jbmister97/projects-hardware/Arduino_Nanite_85/1ec25f11-0269-4718-b098-19f0db2a4db3/Layer_Stack_Manager.png

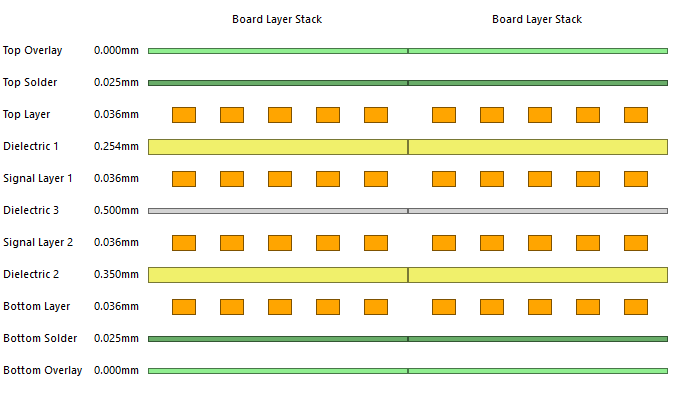
Arduino_Nanite_85/1ec25f11-0269-4718-b098-19f0db2a4db3/Layer_Stack_Manager.png
