jbmister97/projects-hardware/(list of files, drawings)

Other design files:
Arduino_Nanite_85/1ec25f11-0269-4718-b098-19f0db2a4db3/Tiny_Arduino.PrjPcb
Arduino_Nanite_85/1ec25f11-0269-4718-b098-19f0db2a4db3/Tiny_Arduino_Sch.SchDoc
