jbmister97/projects-hardware/Outlet_Relay_V1/Outlet_Relay_V1.kicad_pcb

## KiCad design Outlet_Relay_V1/Outlet_Relay_V1.kicad_pcb (2019-01-05)

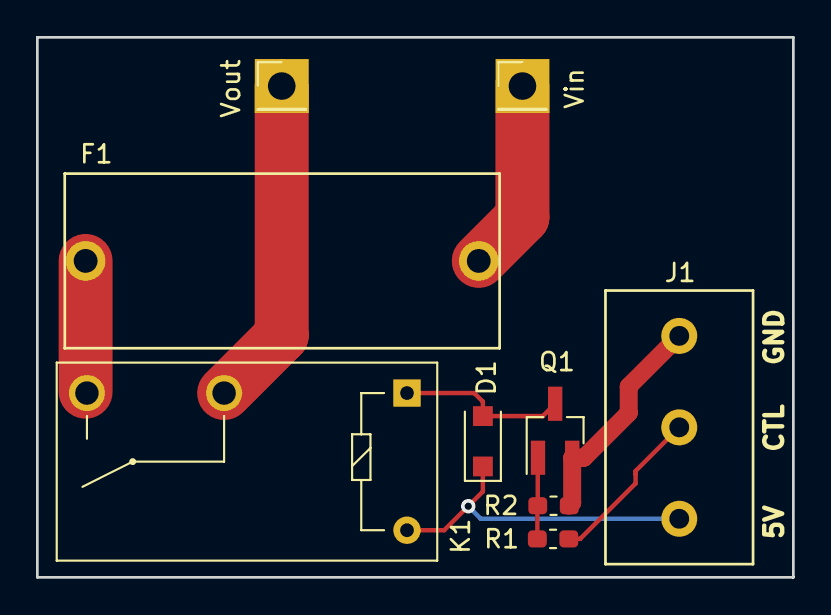
[picture p4: board Outlet_Relay_V1.kicad_pcb from above]

Board: 2 copper layers, 42.0 x 30.0 mm, 9 parts (0 on the bottom side), 8 nets.

Parts:
D1: BAS116H,115; D_SOD-123F
F1: Fuse; Fuse_Holder_Keystone_4527_Cartridge
J1: TerminalBlock_1x3_5.08mmPitch; TerminalBlock_Molex_1x3_5.04mmPitch
K1: G5Q-1A; Relay_SPST_Omron-G5Q-1A
Q1: BSS138K; SOT-23_Handsoldering
R1: 1k; R_0603_1608Metric_Pad1.05x0.95mm_HandSolder
R2: 10k; R_0603_1608Metric_Pad1.05x0.95mm_HandSolder
Vin: PinHeader_1x01_P2.54mm_Vertical
Vout: PinHeader_1x01_P2.54mm_Vertical

Connections:
/5V: D1.1, J1.1, K1.5
/CTL: J1.2, R1.1
GND: J1.3, Q1.2, R2.2
unnamed: D1.2, K1.1, Q1.3
unnamed: F1.1, K1.3
unnamed: Q1.1, R1.2, R2.1
Vin: F1.2, Vin.1
Vout: K1.2, Vout.1
