jbmister97/projects-hardware/Motor_4_Channel_V2/Motor_4_Channel_V2.kicad_pcb

## KiCad design Motor_4_Channel_V2/Motor_4_Channel_V2.kicad_pcb (2019-01-05)

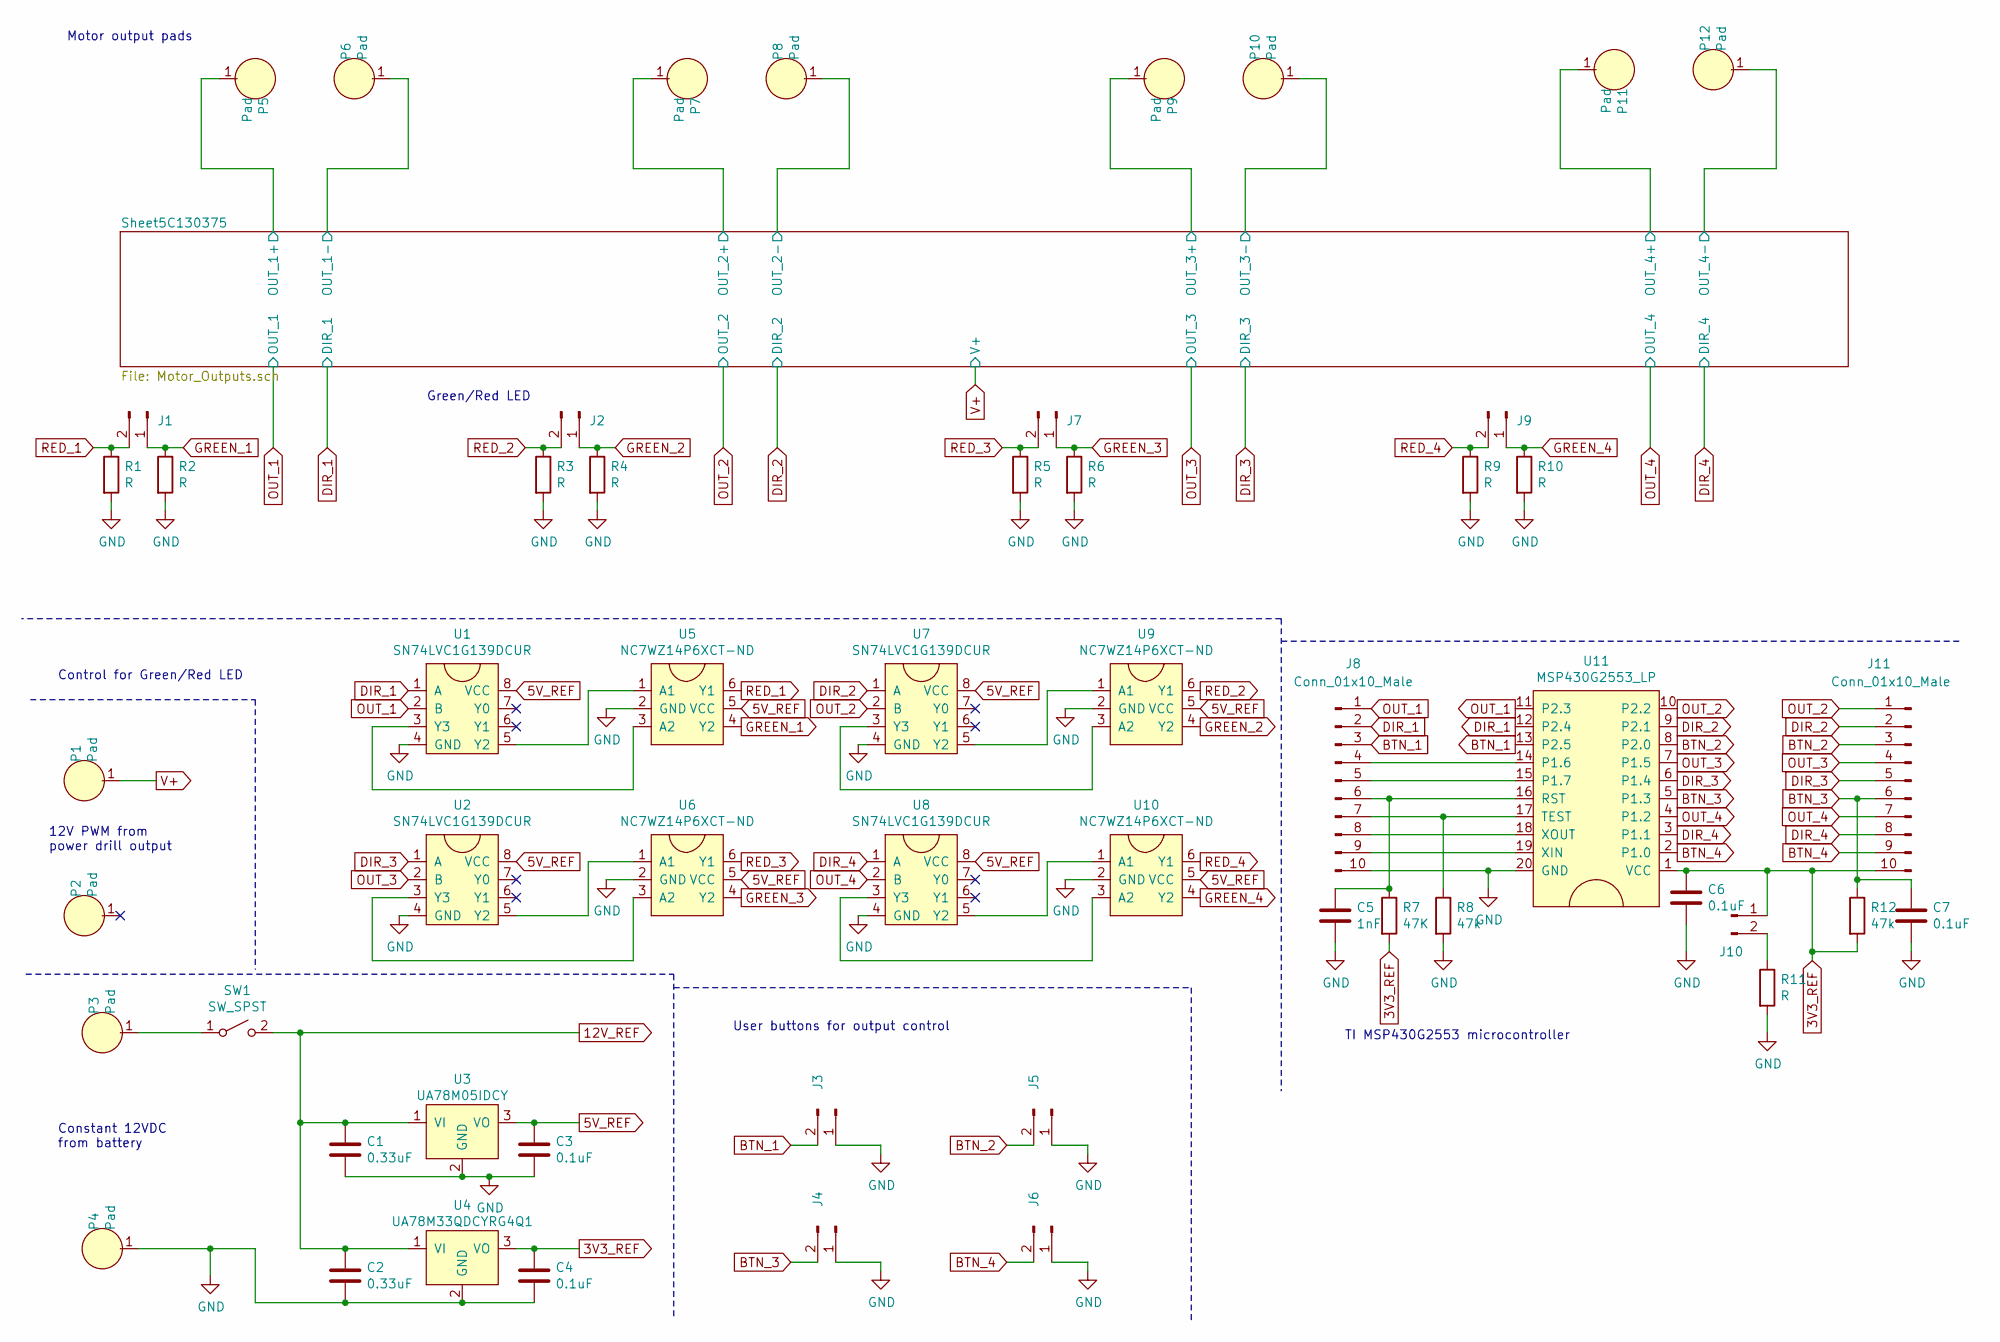
[picture p5: schematic Motor_4_Channel_V2.sch]

Parts:
C1, C2: 0.33uF; C_0603_1608Metric_Pad1.05x0.95mm_HandSolder
C3, C4, C6, C7: 0.1uF; C_0603_1608Metric_Pad1.05x0.95mm_HandSolder
C5: 1nF; C_0603_1608Metric_Pad1.05x0.95mm_HandSolder
J1, J2, J3, J4, J5, J6, J7, J9, J10: Conn_01x02_Male; PinHeader_1x02_P2.54mm_Vertical
J8, J11: Conn_01x10_Male; PinHeader_1x10_P2.54mm_Vertical
P1, P2, P3, P4, P5, P6, P7, P8, P9, P10, P11, P12: Pad
R1, R2, R3, R4, R5, R6, R9, R10, R11: R; R_0603_1608Metric_Pad1.05x0.95mm_HandSolder
R7: 47K; R_0603_1608Metric_Pad1.05x0.95mm_HandSolder
R8, R12: 47k; R_0603_1608Metric_Pad1.05x0.95mm_HandSolder
SW1: SW_SPST; PinHeader_1x02_P2.54mm_Vertical
U1, U2, U7, U8: SN74LVC1G139DCUR; VSSOP-8_2.4x2.1mm_P0.5mm
U3: UA78M05IDCY; SOT-223-3_TabPin2
U4: UA78M33QDCYRG4Q1; SOT-223-3_TabPin2
U5, U6, U9, U10: NC7WZ14P6XCT-ND; SC-70-6
U11: MSP430G2553_LP; DIP-20_W7.62mm_Socket_LongPads

Connections:
3V3_REF: C4.1, C6.1, J10.1, J11.10, R7.2, R12.2, U4.3 (VO), U11.1 (VCC)
5V_REF: C3.1, U1.8 (VCC), U2.8 (VCC), U3.3 (VO), U5.5 (VCC), U6.5 (VCC), U7.8 (VCC), U8.8 (VCC), U9.5 (VCC), U10.5 (VCC)
12V_REF: C1.1, C2.1, SW1.2 (B), U3.1 (VI), U4.1 (VI); also elsewhere on the board
/Sheet5C130375/OUT_1+: P5.1; also elsewhere on the board
/Sheet5C130375/OUT_1-: P6.1; also elsewhere on the board
/Sheet5C130375/OUT_2+: P7.1; also elsewhere on the board
/Sheet5C130375/OUT_2-: P8.1; also elsewhere on the board
/Sheet5C130375/OUT_3+: P9.1; also elsewhere on the board
/Sheet5C130375/OUT_3-: P10.1; also elsewhere on the board
/Sheet5C130375/OUT_4+: P11.1; also elsewhere on the board
/Sheet5C130375/OUT_4-: P12.1; also elsewhere on the board
BTN_1: J3.2, J8.3, U11.13 (P2.5)
BTN_2: J5.2, J11.3, U11.8 (P2.0)
BTN_3: C7.1, J4.2, J11.6, R12.1, U11.5 (P1.3)
BTN_4: J6.2, J11.9, U11.2 (P1.0)
DIR_1: J8.2, U1.1 (A), U11.12 (P2.4); also elsewhere on the board
DIR_2: J11.2, U7.1 (A), U11.9 (P2.1); also elsewhere on the board
DIR_3: J11.5, U2.1 (A), U11.6 (P1.4); also elsewhere on the board
DIR_4: J11.8, U8.1 (A), U11.3 (P1.1); also elsewhere on the board
GND: C1.2, C2.2, C3.2, C4.2, C5.2, C6.2, C7.2, J3.1, J4.1, J5.1, J6.1, J8.10, P4.1, R1.2, R2.2, R3.2, R4.2, R5.2, R6.2, R8.2, R9.2, R10.2, R11.2, U1.4 (GND), U2.4 (GND), U3.2 (GND), U4.2 (GND), U5.2 (GND), U6.2 (GND), U7.4 (GND), U8.4 (GND), U9.2 (GND), U10.2 (GND), U11.20 (GND); also elsewhere on the board
GREEN_1: J1.1, R2.1, U5.4 (Y2)
GREEN_2: J2.1, R4.1, U9.4 (Y2)
GREEN_3: J7.1, R6.1, U6.4 (Y2)
GREEN_4: J9.1, R10.1, U10.4 (Y2)
unnamed: C5.1, J8.6, R7.1, U11.16 (RST)
unnamed: J8.4, U11.14 (P1.6)
unnamed: J8.5, U11.15 (P1.7)
unnamed: J8.7, R8.1, U11.17 (TEST)
unnamed: J8.8, U11.18 (XOUT)
unnamed: J8.9, U11.19 (XIN)
unnamed: J10.2, R11.1
unnamed: P3.1, SW1.1 (A)
unnamed: U1.3 (Y3), U5.3 (A2)
unnamed: U1.5 (Y2), U5.1 (A1)
unnamed: U2.3 (Y3), U6.3 (A2)
unnamed: U2.5 (Y2), U6.1 (A1)
unnamed: U7.3 (Y3), U9.3 (A2)
unnamed: U7.5 (Y2), U9.1 (A1)
unnamed: U8.5 (Y2), U10.1 (A1)
unnamed: U8.3 (Y3), U10.3 (A2)
OUT_1: J8.1, U1.2 (B), U11.11 (P2.3); also elsewhere on the board
OUT_2: J11.1, U7.2 (B), U11.10 (P2.2); also elsewhere on the board
OUT_3: J11.4, U2.2 (B), U11.7 (P1.5); also elsewhere on the board
OUT_4: J11.7, U8.2 (B), U11.4 (P1.2); also elsewhere on the board
RED_1: J1.2, R1.1, U5.6 (Y1)
RED_2: J2.2, R3.1, U9.6 (Y1)
RED_3: J7.2, R5.1, U6.6 (Y1)
RED_4: J9.2, R9.1, U10.6 (Y1)
V+: P1.1; also elsewhere on the board

Notes on the sheet:
Constant 12VDC from battery
12V PWM from power drill output
Control for Green/Red LED
User buttons for output control
TI MSP430G2553 microcontroller
Green/Red LED
Motor output pads

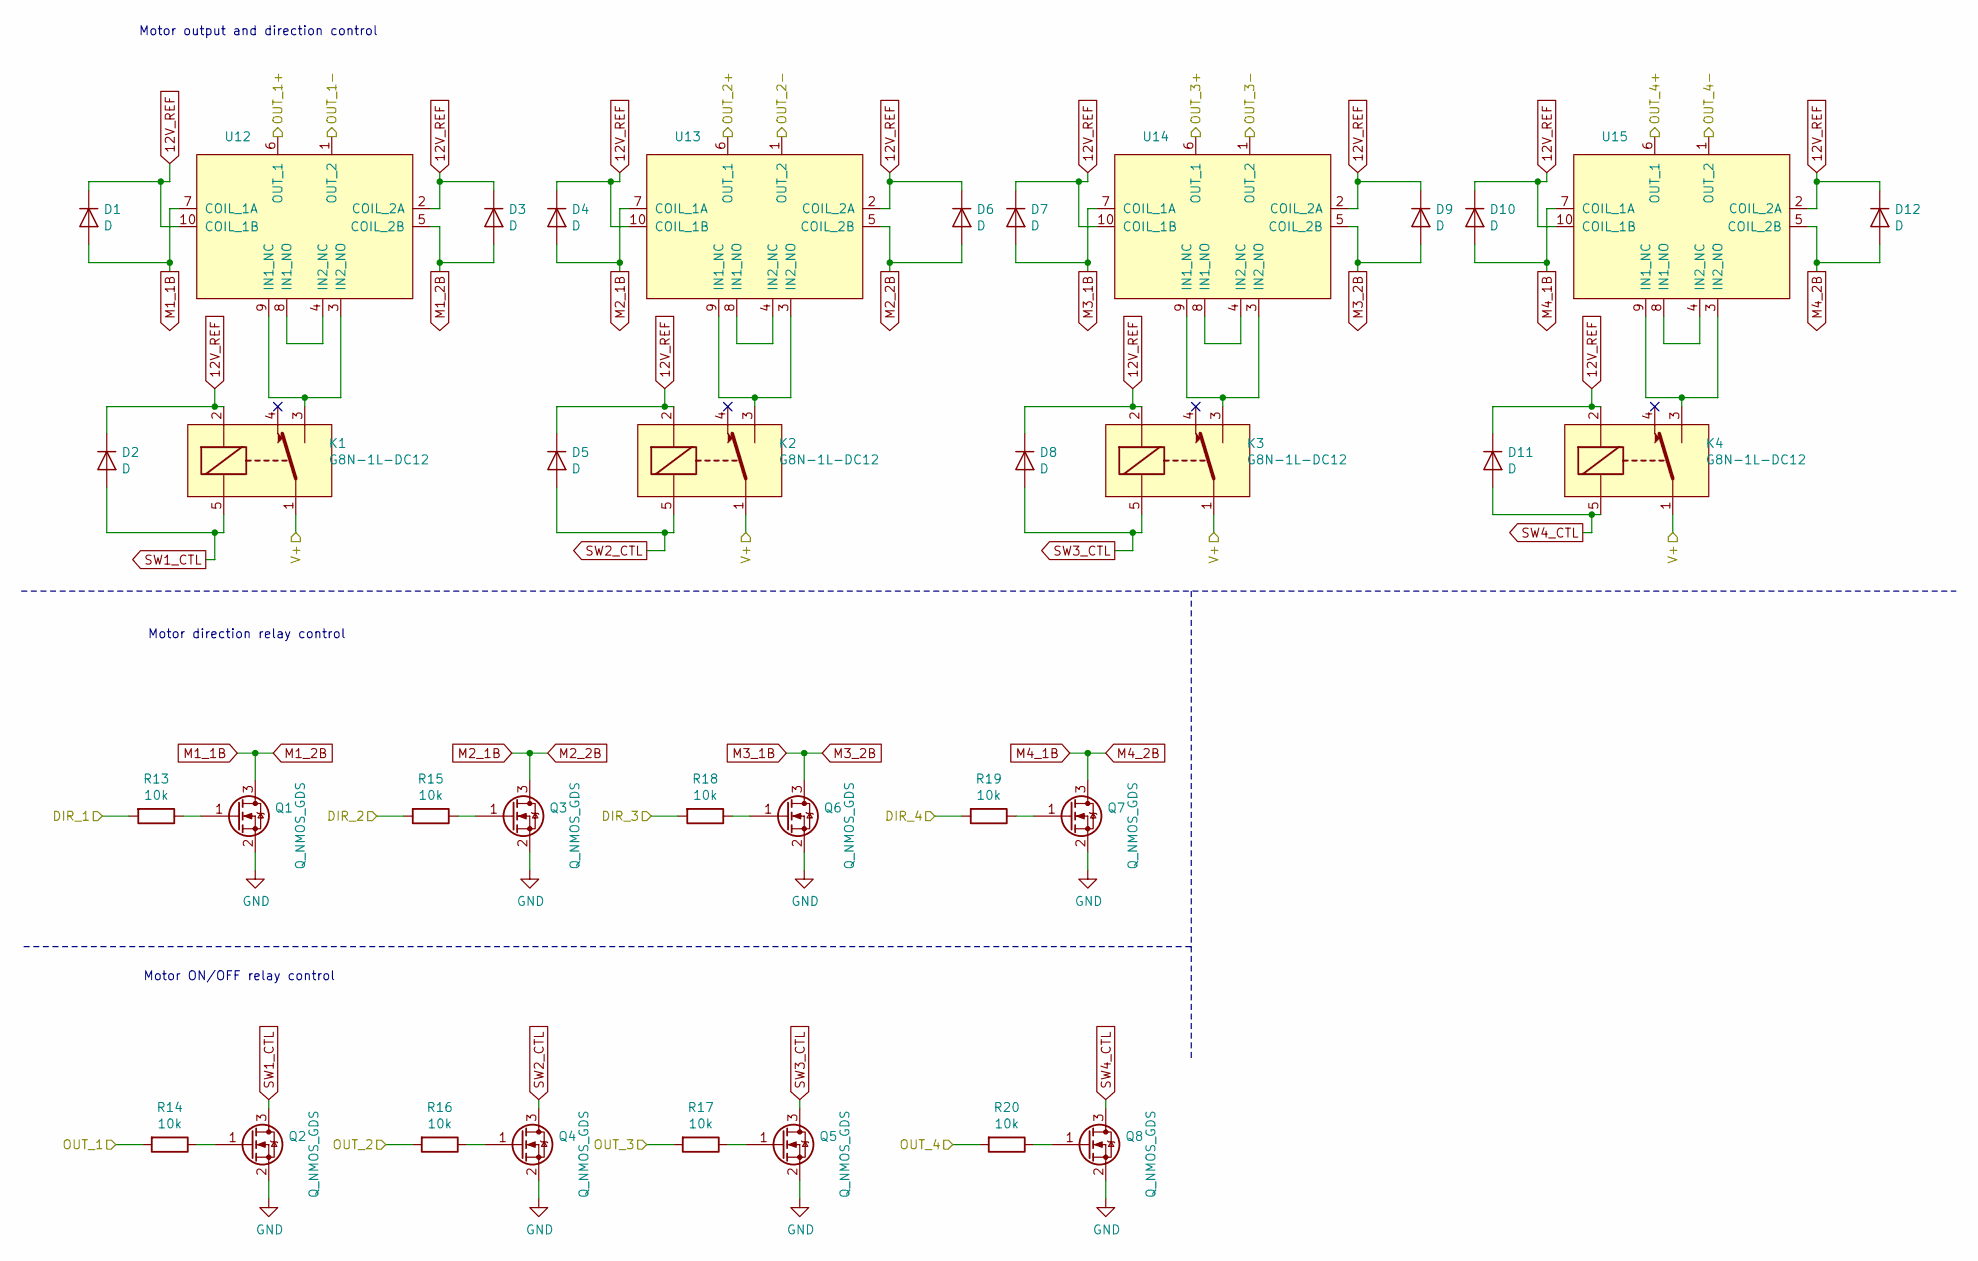
[picture p6: schematic Motor_Outputs.sch]

Parts:
D1, D2, D3, D4, D5, D6, D7, D8, D9, D10, D11, D12: D; DO-214AC
K1, K2, K3, K4: G8N-1L-DC12
Q1, Q2, Q3, Q4, Q5, Q6, Q7, Q8: Q_NMOS_GDS; SOT-23
R13, R14, R15, R16, R17, R18, R19, R20: 10k; R_0603_1608Metric_Pad1.05x0.95mm_HandSolder
U12, U13, U14, U15: G8NW-2H-DC12

Connections:
12V_REF: D1.1 (K), D2.1 (K), D3.1 (K), D4.1 (K), D5.1 (K), D6.1 (K), D7.1 (K), D8.1 (K), D9.1 (K), D10.1 (K), D11.1 (K), D12.1 (K), K1.2, K2.2, K3.2, K4.2, U12.2 (COIL_2A), U12.10 (COIL_1B), U13.2 (COIL_2A), U13.10 (COIL_1B), U14.2 (COIL_2A), U14.10 (COIL_1B), U15.2 (COIL_2A), U15.10 (COIL_1B); also elsewhere on the board
/Sheet5C130375/OUT_1+: U12.6 (OUT_1); also elsewhere on the board
/Sheet5C130375/OUT_1-: U12.1 (OUT_2); also elsewhere on the board
/Sheet5C130375/OUT_2+: U13.6 (OUT_1); also elsewhere on the board
/Sheet5C130375/OUT_2-: U13.1 (OUT_2); also elsewhere on the board
/Sheet5C130375/OUT_3+: U14.6 (OUT_1); also elsewhere on the board
/Sheet5C130375/OUT_3-: U14.1 (OUT_2); also elsewhere on the board
/Sheet5C130375/OUT_4+: U15.6 (OUT_1); also elsewhere on the board
/Sheet5C130375/OUT_4-: U15.1 (OUT_2); also elsewhere on the board
DIR_1: R13.2; also elsewhere on the board
DIR_2: R15.2; also elsewhere on the board
DIR_3: R18.2; also elsewhere on the board
DIR_4: R19.2; also elsewhere on the board
GND: Q1.2 (S), Q2.2 (S), Q3.2 (S), Q4.2 (S), Q5.2 (S), Q6.2 (S), Q7.2 (S), Q8.2 (S); also elsewhere on the board
M1_1B: D1.2 (A), D3.2 (A), Q1.3 (D), U12.5 (COIL_2B), U12.7 (COIL_1A)
M2_1B: D4.2 (A), D6.2 (A), Q3.3 (D), U13.5 (COIL_2B), U13.7 (COIL_1A)
M3_1B: D7.2 (A), D9.2 (A), Q6.3 (D), U14.5 (COIL_2B), U14.7 (COIL_1A)
M4_1B: D10.2 (A), D12.2 (A), Q7.3 (D), U15.5 (COIL_2B), U15.7 (COIL_1A)
unnamed: K1.3, U12.3 (IN2_NO), U12.9 (IN1_NC)
unnamed: K2.3, U13.3 (IN2_NO), U13.9 (IN1_NC)
unnamed: K3.3, U14.3 (IN2_NO), U14.9 (IN1_NC)
unnamed: K4.3, U15.3 (IN2_NO), U15.9 (IN1_NC)
unnamed: Q1.1 (G), R13.1
unnamed: Q2.1 (G), R14.1
unnamed: Q3.1 (G), R15.1
unnamed: Q4.1 (G), R16.1
unnamed: Q5.1 (G), R17.1
unnamed: Q6.1 (G), R18.1
unnamed: Q7.1 (G), R19.1
unnamed: Q8.1 (G), R20.1
unnamed: U12.4 (IN2_NC), U12.8 (IN1_NO)
unnamed: U13.4 (IN2_NC), U13.8 (IN1_NO)
unnamed: U14.4 (IN2_NC), U14.8 (IN1_NO)
unnamed: U15.4 (IN2_NC), U15.8 (IN1_NO)
OUT_1: R14.2; also elsewhere on the board
OUT_2: R16.2; also elsewhere on the board
OUT_3: R17.2; also elsewhere on the board
OUT_4: R20.2; also elsewhere on the board
SW1_CTL: D2.2 (A), K1.5, Q2.3 (D)
SW2_CTL: D5.2 (A), K2.5, Q4.3 (D)
SW3_CTL: D8.2 (A), K3.5, Q5.3 (D)
SW4_CTL: D11.2 (A), K4.5, Q8.3 (D)
V+: K1.1, K2.1, K3.1, K4.1; also elsewhere on the board

Notes on the sheet:
Motor output and direction control
Motor direction relay control
Motor ON/OFF relay control

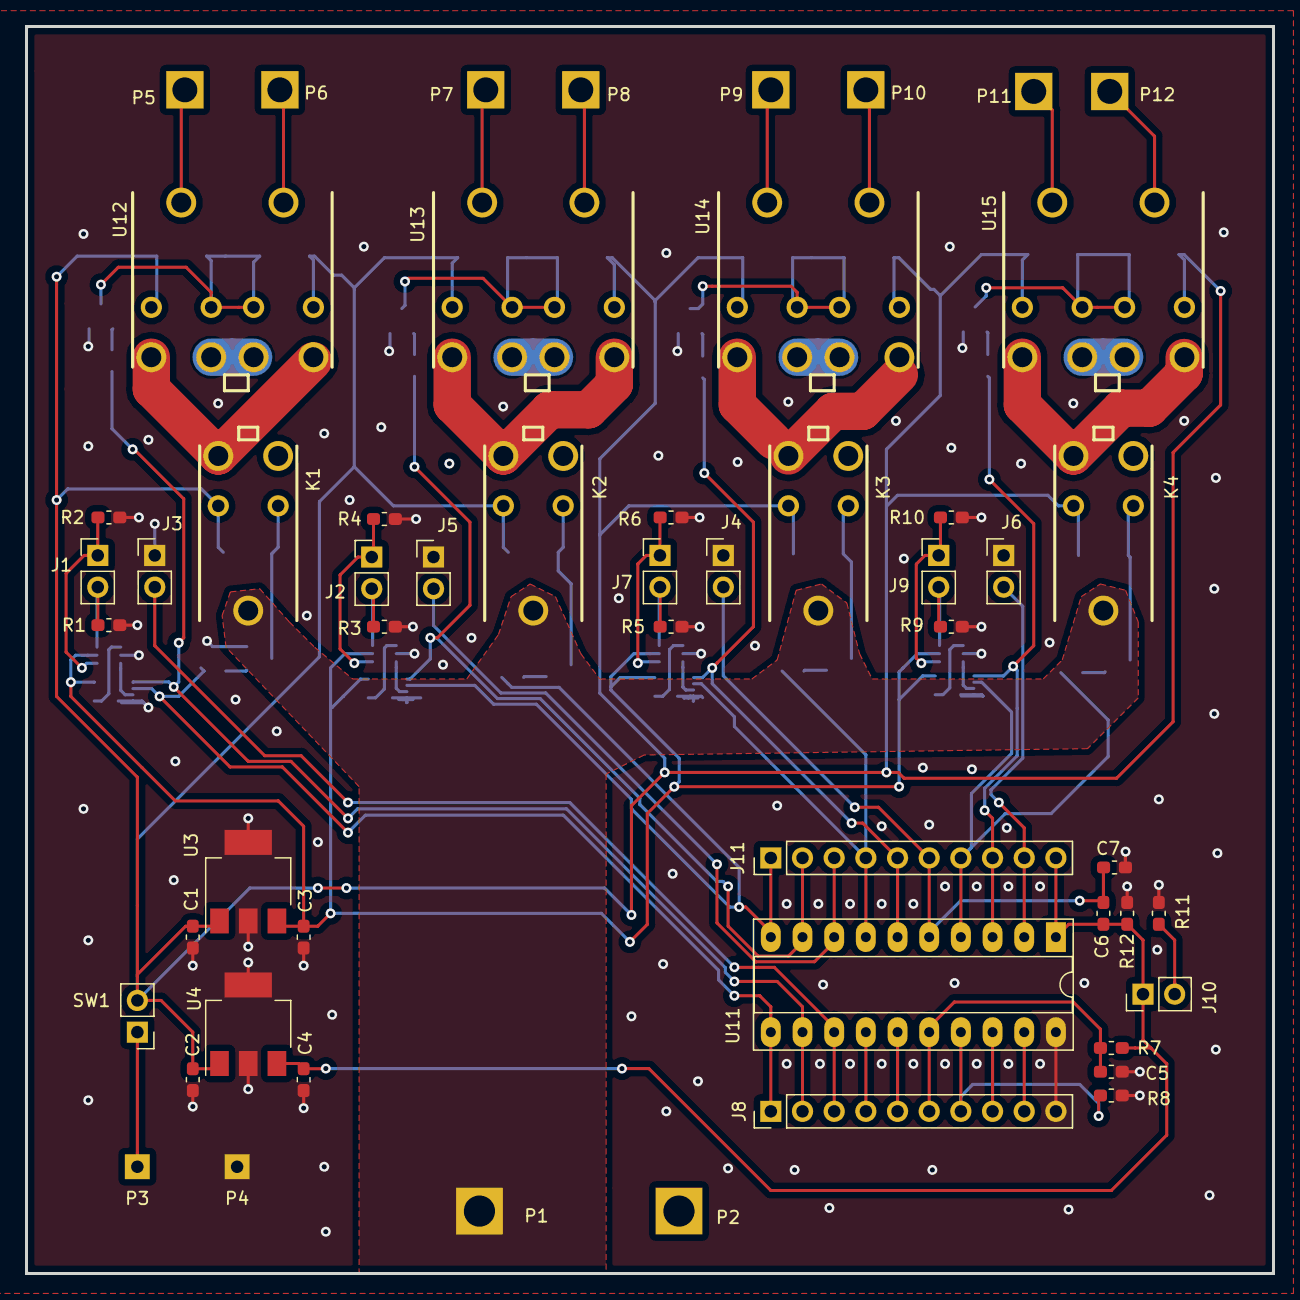
[picture p7: board Motor_4_Channel_V2.kicad_pcb from above]

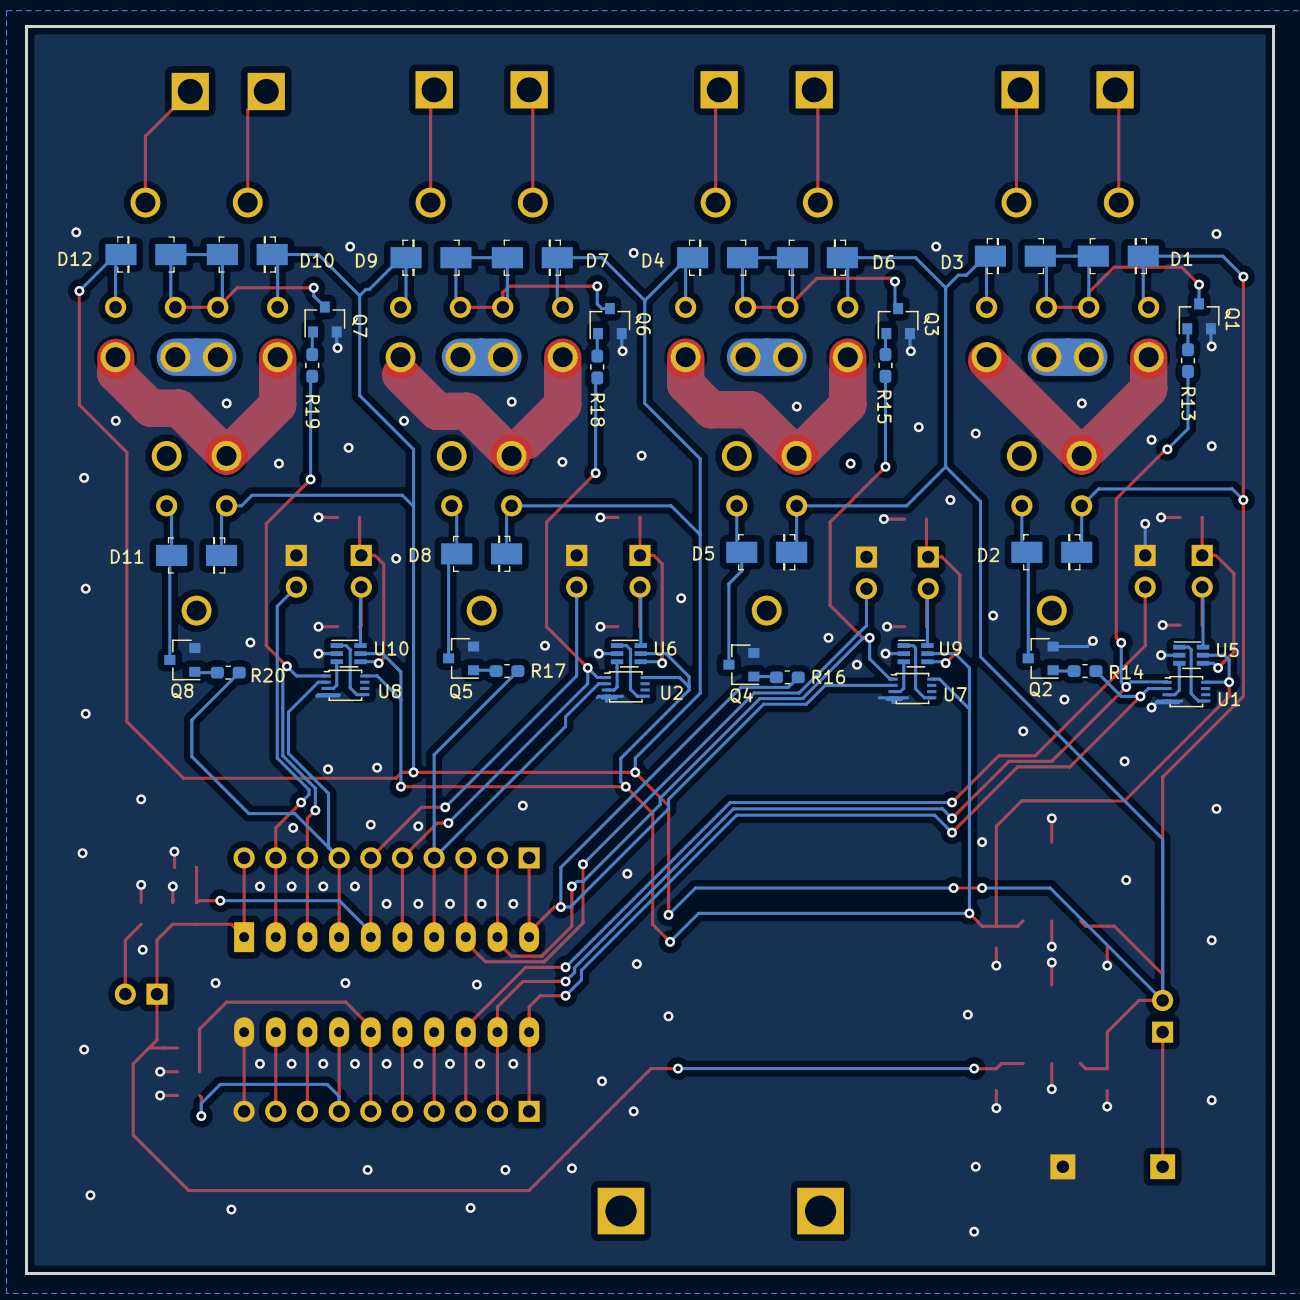
[picture p8: board Motor_4_Channel_V2.kicad_pcb from below]

Board: 2 copper layers, 100.0 x 100.0 mm, 90 parts (36 on the bottom side), 73 nets.
