jbmister97/projects-hardware/Buck_Converter_V1/Buck_Converter_V1.kicad_pcb

## KiCad design Buck_Converter_V1/Buck_Converter_V1.kicad_pcb (2019-01-05)

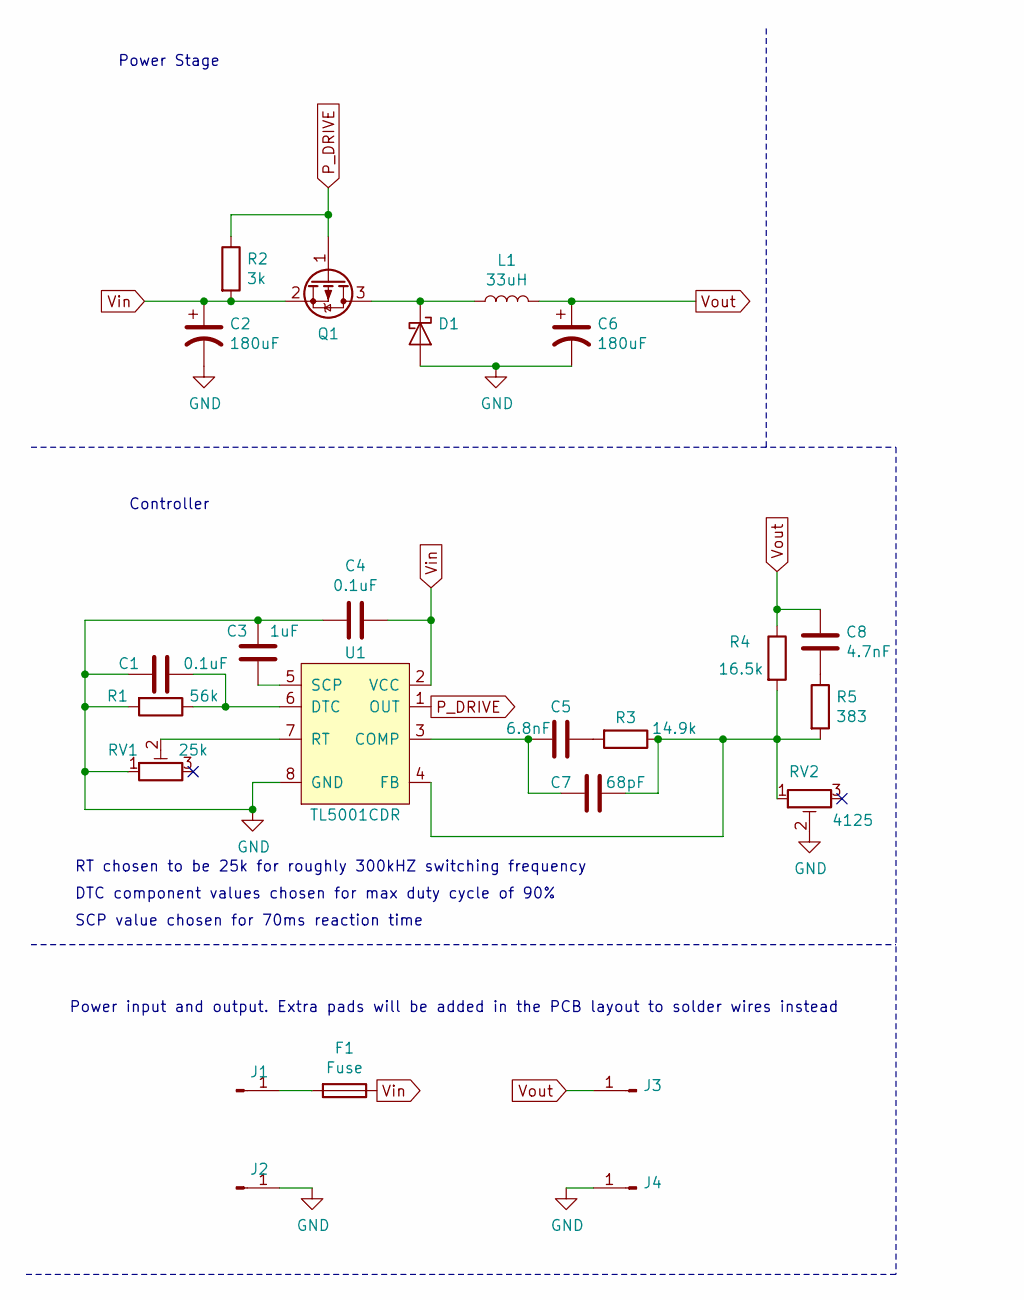
[picture p9: schematic Buck_Converter_V1.sch]

Parts:
C1, C4: 0.1uF; C_0603_1608Metric_Pad1.05x0.95mm_HandSolder
C2, C6: 180uF; C_AlPo_Radial_SMT_8.3mmx8.3mm
C3: 1uF; C_0603_1608Metric_Pad1.05x0.95mm_HandSolder
C5: 6.8nF; C_0603_1608Metric_Pad1.05x0.95mm_HandSolder
C7: 68pF; C_0603_1608Metric_Pad1.05x0.95mm_HandSolder
C8: 4.7nF; C_0603_1608Metric_Pad1.05x0.95mm_HandSolder
D1: NRVTSA4100ET3G; D_SMA_Handsoldering
F1: Fuse; Fuse_0603_1608Metric_Pad1.05x0.95mm_HandSolder
J1, J2, J3, J4: Conn_01x01_Male; PinHeader_1x01_P2.54mm_Vertical
L1: 33uH; L_12x12mm_H8mm
Q1: SI2319CDS-T1-GE3; SOT-23_Handsoldering
R1: 56k; R_0603_1608Metric_Pad1.05x0.95mm_HandSolder
R2: 3k; R_0603_1608Metric_Pad1.05x0.95mm_HandSolder
R3: 14.9k; R_0603_1608Metric_Pad1.05x0.95mm_HandSolder
R4: 16.5k; R_0603_1608Metric_Pad1.05x0.95mm_HandSolder
R5: 383; R_0603_1608Metric_Pad1.05x0.95mm_HandSolder
RV1: 25k; Potentiometer_Bourns_3296W_Vertical
RV2: 4125; Potentiometer_Bourns_3296W_Vertical
U1: TL5001CDR; SOIC-8_3.9x4.9mm_P1.27mm

Connections:
GND: C1.2, C2.2, C3.1, C4.2, C6.2, D1.2 (A), J2.1, J4.1, R1.2, RV1.1, RV2.2, U1.8 (GND); also elsewhere on the board
unnamed: C1.1, R1.1, U1.6 (DTC)
unnamed: C3.2, U1.5 (SCP)
unnamed: C5.1, R3.2
unnamed: C5.2, C7.2, U1.3 (COMP)
unnamed: C7.1, R3.1, R4.2, R5.2, RV2.1, U1.4 (FB)
unnamed: C8.2, R5.1
unnamed: D1.1 (K), L1.1, Q1.3 (D)
unnamed 8: F1.2, J1.1; also elsewhere on the board
unnamed: RV1.2, U1.7 (RT)
P_DRIVE: Q1.1 (G), R2.1, U1.1 (OUT)
Vin: C2.1, C4.1, F1.1, Q1.2 (S), R2.2, U1.2 (VCC)
Vout: C6.1, C8.1, J3.1, L1.2, R4.1; also elsewhere on the board

Notes on the sheet:
Power Stage
Controller
RT chosen to be 25k for roughly 300kHZ switching frequency
DTC component values chosen for max duty cycle of 90%
SCP value chosen for 70ms reaction time
Power input and output. Extra pads will be added in the PCB layout to solder wires instead

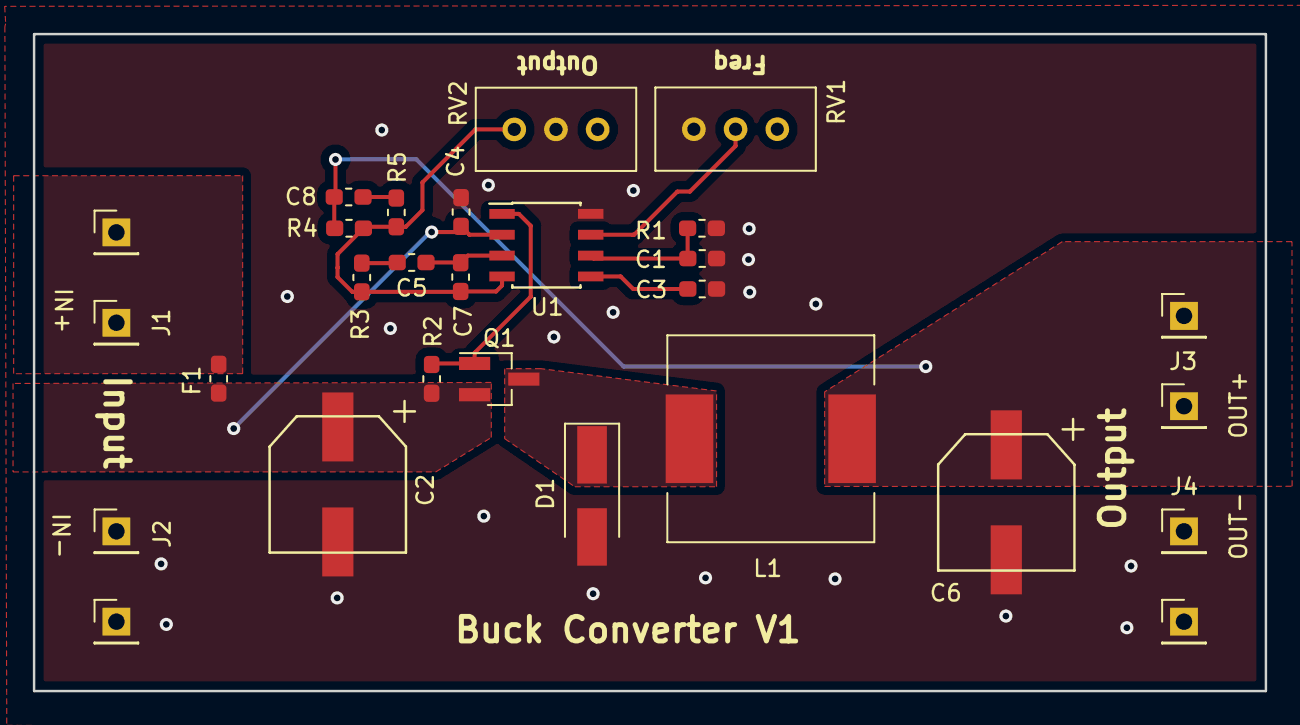
[picture p10: board Buck_Converter_V1.kicad_pcb from above]

Board: 2 copper layers, 75.0 x 40.0 mm, 28 parts (0 on the bottom side), 13 nets.

Other parts of the board:
IN+: PinHeader_1x01_P2.54mm_Vertical
IN-: PinHeader_1x01_P2.54mm_Vertical
OUT+: PinHeader_1x01_P2.54mm_Vertical
OUT-: PinHeader_1x01_P2.54mm_Vertical

Their connections:
GND: IN-.1, OUT-.1; also elsewhere on the board
unnamed 8: IN+.1; also elsewhere on the board
Vout: OUT+.1; also elsewhere on the board
