jbmister97/projects-hardware/NRF52832_Reference/NRF52832_Reference.kicad_pcb

## KiCad design NRF52832_Reference/NRF52832_Reference.kicad_pcb (2018-12-15)

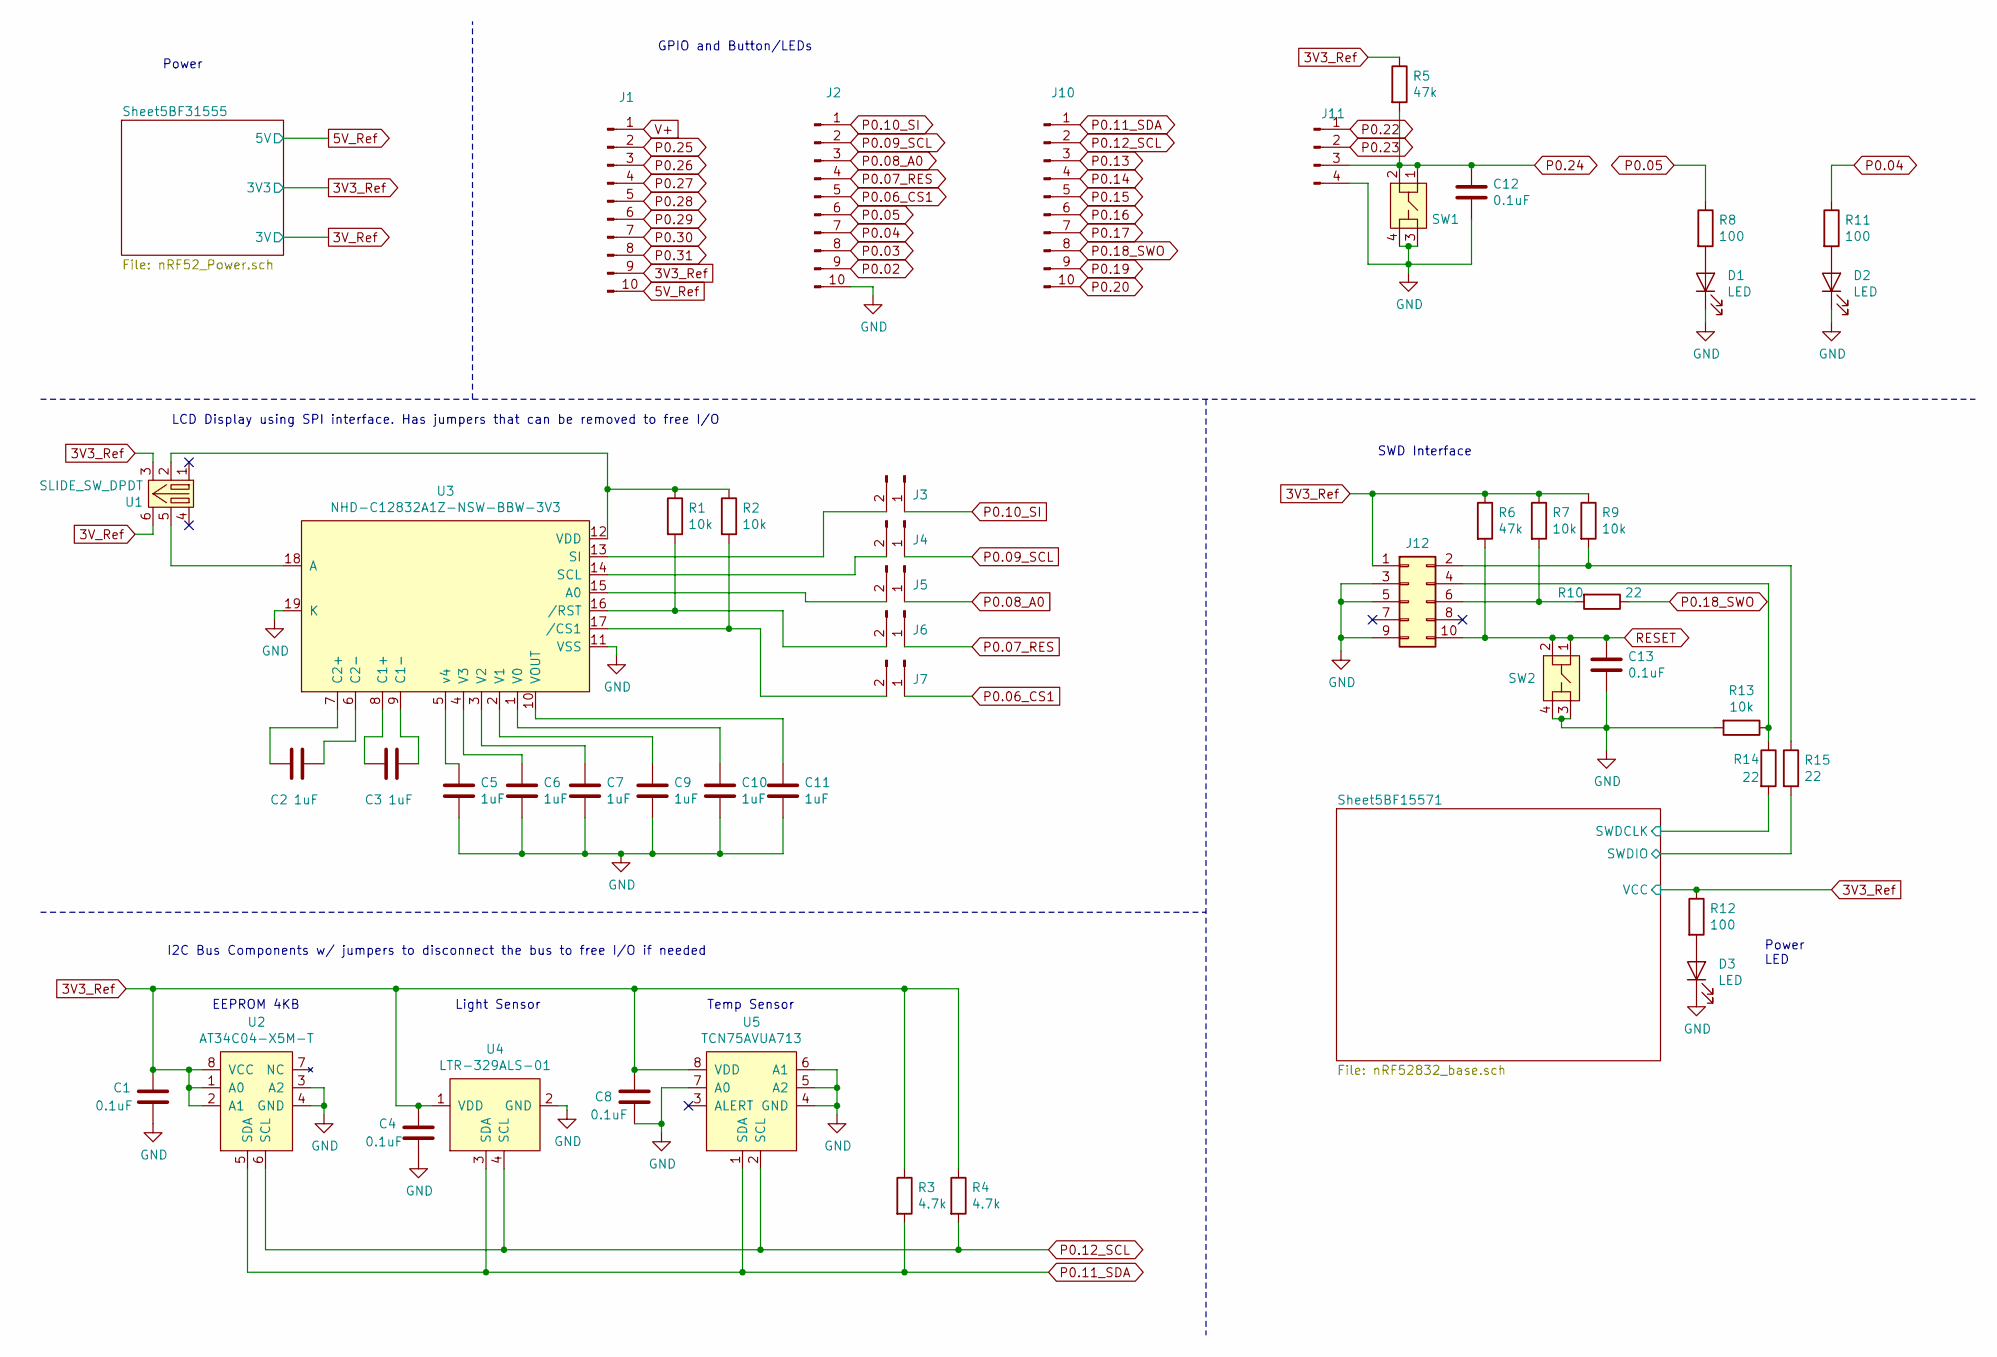
[picture p11: schematic NRF52832_Reference.sch]

Parts:
C1, C4, C8, C12, C13: 0.1uF; C_0603_1608Metric_Pad1.05x0.95mm_HandSolder
C2, C3, C5, C6, C7, C9, C10, C11: 1uF; C_0603_1608Metric_Pad1.05x0.95mm_HandSolder
D1, D2, D3: LED; LED_0603_1608Metric_Pad1.05x0.95mm_HandSolder
J1, J2, J10: Conn_01x10_Male; PinHeader_1x10_P2.54mm_Vertical
J3, J4, J5, J6, J7: Conn_01x02_Male; PinHeader_1x02_P2.54mm_Vertical
J11: Conn_01x04_Male; PinHeader_1x04_P2.54mm_Vertical
J12: SWD_Header; SWD_Header_CNC_Tech_3220-10-0100-00
R1, R2, R7, R9, R13: 10k; R_0603_1608Metric_Pad1.05x0.95mm_HandSolder
R3, R4: 4.7k; R_0603_1608Metric_Pad1.05x0.95mm_HandSolder
R5, R6: 47k; R_0603_1608Metric_Pad1.05x0.95mm_HandSolder
R8, R11, R12: 100; R_0603_1608Metric_Pad1.05x0.95mm_HandSolder
R10, R14, R15: 22; R_0603_1608Metric_Pad1.05x0.95mm_HandSolder
SW1, SW2: Button; SW_Tactile_TE_1825910-6
U1: SLIDE_SW_DPDT; SW_DPDT_Slide_JS202011CQN
U2: AT34C04-X5M-T; TSSOP-8_4.4x3mm_P0.65mm
U3: NHD-C12832A1Z-NSW-BBW-3V3; LCD_NHD-C12832A1Z-NSW-BBW-3V3
U4: LTR-329ALS-01; Sensor_Photo_LTR-329ALS-01
U5: TCN75AVUA713; MSOP-8_3x3mm_P0.65mm

Connections:
3V3_Ref: C1.1, C4.1, C8.1, J1.9, J12.1, R3.1, R4.1, R5.1, R6.1, R7.1, R9.1, R12.1, U1.3, U2.1 (A0), U2.2 (A1), U2.8 (VCC), U4.1 (VDD), U5.8 (VDD); also elsewhere on the board
3V_Ref: U1.6; also elsewhere on the board
5V_Ref: J1.10; also elsewhere on the board
/Sheet5BF15571/SWDCLK: R14.2; also elsewhere on the board
/Sheet5BF15571/SWDIO: R15.2; also elsewhere on the board
GND: C1.2, C4.2, C5.2, C6.2, C7.2, C8.2, C9.2, C10.2, C11.2, C12.2, C13.2, D1.1 (K), D2.1 (K), D3.1 (K), J2.10, J11.4, J12.3, J12.5, J12.9, R13.2, SW1.3, SW1.4, SW2.3, SW2.4, U2.3 (A2), U2.4 (GND), U3.11 (VSS), U3.19 (K), U4.2 (GND), U5.4 (GND), U5.5 (A2), U5.6 (A1), U5.7 (A0); also elsewhere on the board
unnamed: C2.1, U3.6 (C2-)
unnamed: C2.2, U3.7 (C2+)
unnamed: C3.1, U3.9 (C1-)
unnamed: C3.2, U3.8 (C1+)
unnamed: C5.1, U3.5 (v4)
unnamed: C6.1, U3.4 (V3)
unnamed: C7.1, U3.3 (V2)
unnamed: C9.1, U3.2 (V1)
unnamed: C10.1, U3.1 (V0)
unnamed: C11.1, U3.10 (VOUT)
unnamed: D1.2 (A), R8.2
unnamed: D2.2 (A), R11.2
unnamed: D3.2 (A), R12.2
unnamed: J3.2, U3.13 (SI)
unnamed: J4.2, U3.14 (SCL)
unnamed: J5.2, U3.15 (A0)
unnamed: J6.2, R1.2, U3.16 (/RST)
unnamed: J7.2, R2.2, U3.17 (/CS1)
unnamed: J12.2, R9.2, R15.1
unnamed: J12.4, R13.1, R14.1
unnamed: J12.6, R7.2, R10.2
unnamed: R1.1, R2.1, U1.2, U3.12 (VDD)
unnamed: U1.5, U3.18 (A)
P0.02: J2.9; also elsewhere on the board
P0.03: J2.8; also elsewhere on the board
P0.04: J2.7, R11.1; also elsewhere on the board
P0.05: J2.6, R8.1; also elsewhere on the board
P0.06_CS1: J2.5, J7.1; also elsewhere on the board
P0.07_RES: J2.4, J6.1; also elsewhere on the board
P0.08_A0: J2.3, J5.1; also elsewhere on the board
P0.09_SCL: J2.2, J4.1; also elsewhere on the board
P0.10_SI: J2.1, J3.1; also elsewhere on the board
P0.11_SDA: J10.1, R3.2, U2.5 (SDA), U4.3 (SDA), U5.1 (SDA); also elsewhere on the board
P0.12_SCL: J10.2, R4.2, U2.6 (SCL), U4.4 (SCL), U5.2 (SCL); also elsewhere on the board
P0.13: J10.3; also elsewhere on the board
P0.14: J10.4; also elsewhere on the board
P0.15: J10.5; also elsewhere on the board
P0.16: J10.6; also elsewhere on the board
P0.17: J10.7; also elsewhere on the board
P0.18_SWO: J10.8, R10.1; also elsewhere on the board
P0.19: J10.9; also elsewhere on the board
P0.20: J10.10; also elsewhere on the board
P0.22: J11.1; also elsewhere on the board
P0.23: J11.2; also elsewhere on the board
P0.24: C12.1, J11.3, R5.2, SW1.1, SW1.2; also elsewhere on the board
P0.25: J1.2; also elsewhere on the board
P0.26: J1.3; also elsewhere on the board
P0.27: J1.4; also elsewhere on the board
P0.28: J1.5; also elsewhere on the board
P0.29: J1.6; also elsewhere on the board
P0.30: J1.7; also elsewhere on the board
P0.31: J1.8; also elsewhere on the board
RESET: C13.1, J12.10, R6.2, SW2.1, SW2.2; also elsewhere on the board
V+: J1.1; also elsewhere on the board

Notes on the sheet:
SWD Interface
Power
Power LED
I2C Bus Components w/ jumpers to disconnect the bus to free I/O if needed
Light Sensor
Temp Sensor
EEPROM 4KB
LCD Display using SPI interface. Has jumpers that can be removed to free I/O
GPIO and Button/LEDs
