jbmister97/projects-hardware/NRF52832_Reference/NRF52832_Reference.kicad_pcb

## KiCad design NRF52832_Reference/NRF52832_Reference.kicad_pcb (continued)

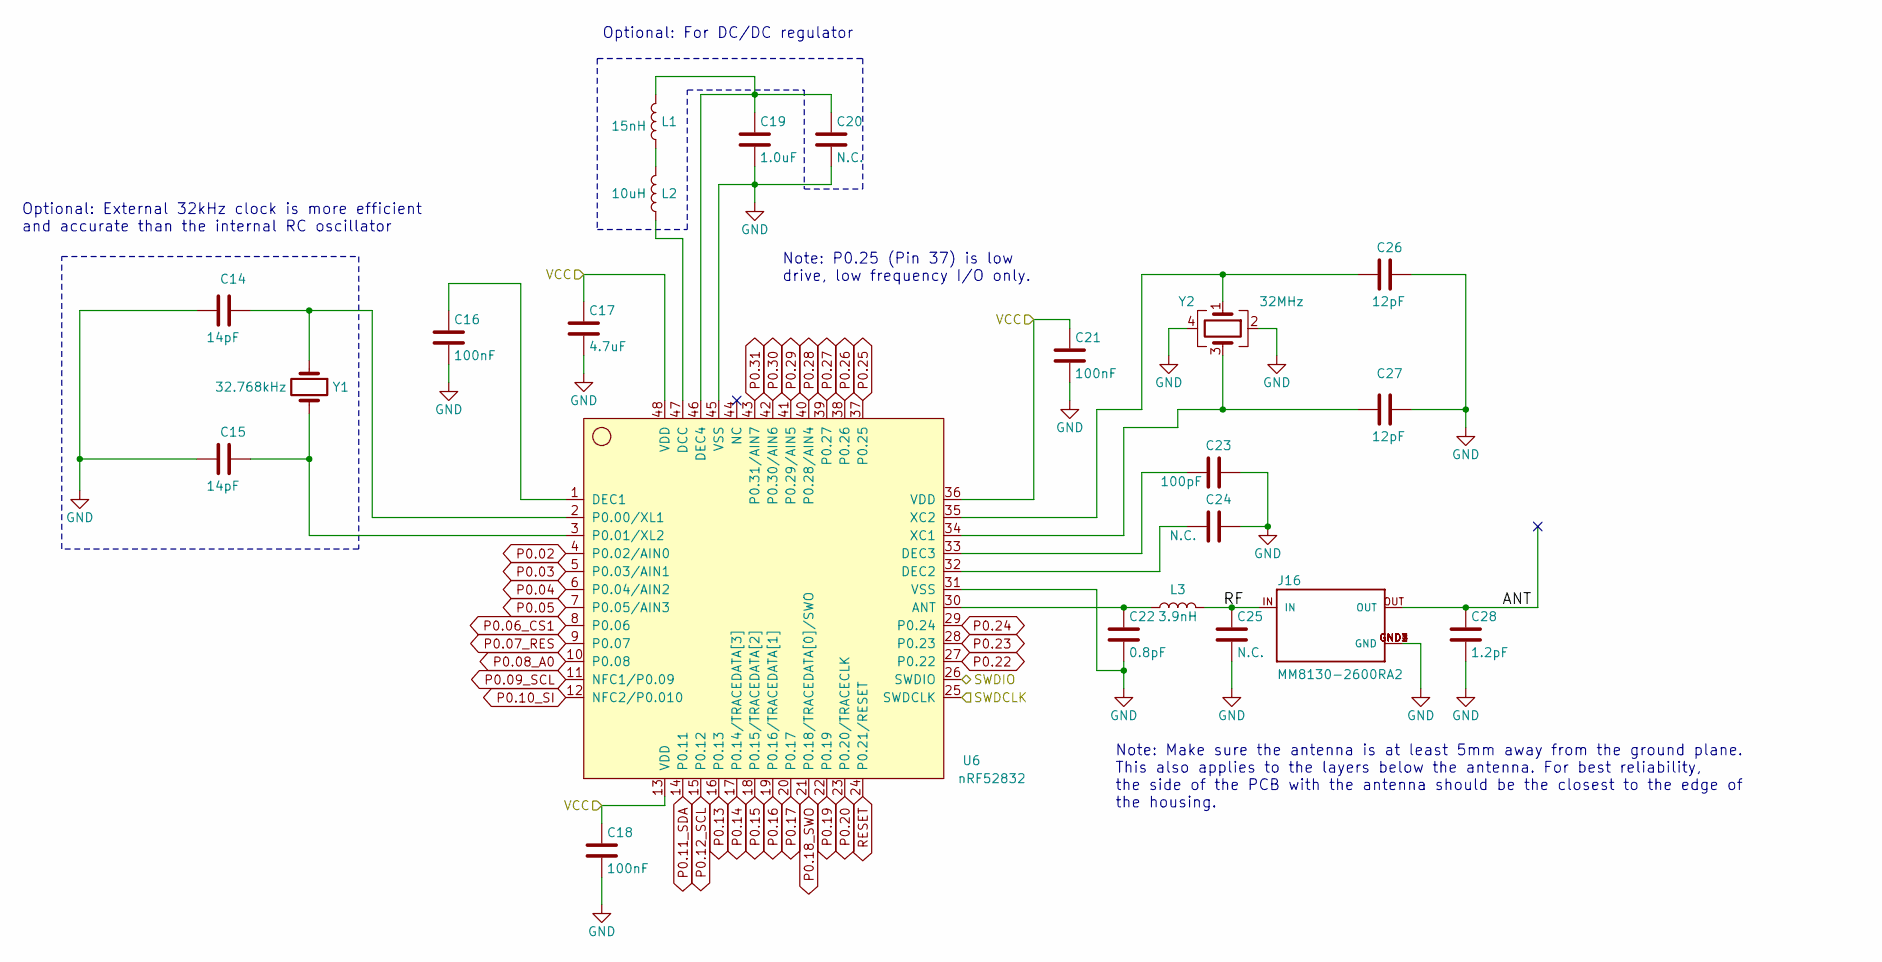
[picture p12: schematic nRF52832_base.sch]

Parts:
C14, C15: 14pF; C_0402_1005Metric
C16, C18, C21: 100nF; C_0402_1005Metric
C17: 4.7uF; C_0603_1608Metric
C19: 1.0uF; C_0603_1608Metric
C20: N.C.; C_0603_1608Metric
C22: 0.8pF; C_0402_1005Metric
C23: 100pF; C_0402_1005Metric
C24, C25: N.C.; C_0402_1005Metric
C26, C27: 12pF; C_0402_1005Metric
C28: 1.2pF; C_0402_1005Metric
J16: MM8130-2600RA2; MURATA_MM8130-2600RA2
L1: 15nH; L_0402_1005Metric
L2: 10uH; L_0603_1608Metric
L3: 3.9nH; L_0402_1005Metric
U6: nRF52832; QFN-48-1EP_6x6mm_P0.4mm_EP4.3x4.3mm_ThermalVias
Y1: 32.768kHz; Crystal_SMD_3215-2Pin_3.2x1.5mm
Y2: 32MHz; Crystal_32MHz_Kyocera_CX3225SB32000D0FFFCC

Connections:
3V3_Ref: C17.1, C18.1, C21.1, U6.13 (VDD), U6.36 (VDD), U6.48 (VDD); also elsewhere on the board
/Sheet5BF15571/ANT: C28.1, J16.OUT
/Sheet5BF15571/RF: C25.1, J16.IN, L3.2
/Sheet5BF15571/SWDCLK: U6.25 (SWDCLK); also elsewhere on the board
/Sheet5BF15571/SWDIO: U6.26 (SWDIO); also elsewhere on the board
GND: C14.2, C15.2, C16.2, C17.2, C18.2, C19.2, C20.2, C21.2, C22.2, C23.1, C24.1, C25.2, C26.1, C27.1, C28.2, J16.GND1 (GND), J16.GND2 (GND), J16.GND3 (GND), J16.GND4 (GND), U6.31 (VSS), U6.45 (VSS), U6.49, Y2.2, Y2.4; also elsewhere on the board
unnamed: C14.1, U6.2 (P0.00/XL1), Y1.1
unnamed: C15.1, U6.3 (P0.01/XL2), Y1.2
unnamed: C16.1, U6.1 (DEC1)
unnamed: C19.1, C20.1, L1.2, U6.46 (DEC4)
unnamed: C22.1, L3.1, U6.30 (ANT)
unnamed: C23.2, U6.33 (DEC3)
unnamed: C24.2, U6.32 (DEC2)
unnamed: C26.2, U6.35 (XC2), Y2.1
unnamed: C27.2, U6.34 (XC1), Y2.3
unnamed: L1.1, L2.2
unnamed: L2.1, U6.47 (DCC)
P0.02: U6.4 (P0.02/AIN0); also elsewhere on the board
P0.03: U6.5 (P0.03/AIN1); also elsewhere on the board
P0.04: U6.6 (P0.04/AIN2); also elsewhere on the board
P0.05: U6.7 (P0.05/AIN3); also elsewhere on the board
P0.06_CS1: U6.8 (P0.06); also elsewhere on the board
P0.07_RES: U6.9 (P0.07); also elsewhere on the board
P0.08_A0: U6.10 (P0.08); also elsewhere on the board
P0.09_SCL: U6.11 (NFC1/P0.09); also elsewhere on the board
P0.10_SI: U6.12 (NFC2/P0.010); also elsewhere on the board
P0.11_SDA: U6.14 (P0.11); also elsewhere on the board
P0.12_SCL: U6.15 (P0.12); also elsewhere on the board
P0.13: U6.16 (P0.13); also elsewhere on the board
P0.14: U6.17 (P0.14/TRACEDATA[3]); also elsewhere on the board
P0.15: U6.18 (P0.15/TRACEDATA[2]); also elsewhere on the board
P0.16: U6.19 (P0.16/TRACEDATA[1]); also elsewhere on the board
P0.17: U6.20 (P0.17); also elsewhere on the board
P0.18_SWO: U6.21 (P0.18/TRACEDATA[0]/SWO); also elsewhere on the board
P0.19: U6.22 (P0.19); also elsewhere on the board
P0.20: U6.23 (P0.20/TRACECLK); also elsewhere on the board
P0.22: U6.27 (P0.22); also elsewhere on the board
P0.23: U6.28 (P0.23); also elsewhere on the board
P0.24: U6.29 (P0.24); also elsewhere on the board
P0.25: U6.37 (P0.25); also elsewhere on the board
P0.26: U6.38 (P0.26); also elsewhere on the board
P0.27: U6.39 (P0.27); also elsewhere on the board
P0.28: U6.40 (P0.28/AIN4); also elsewhere on the board
P0.29: U6.41 (P0.29/AIN5); also elsewhere on the board
P0.30: U6.42 (P0.30/AIN6); also elsewhere on the board
P0.31: U6.43 (P0.31/AIN7); also elsewhere on the board
RESET: U6.24 (P0.21/RESET); also elsewhere on the board

Notes on the sheet:
Note: Make sure the antenna is at least 5mm away from the ground plane. This also applies to the layers below the antenna. For best reliability, the side of the PCB with the antenna should be the closest to the edge of the housing.
Optional: For DC/DC regulator
Optional: External 32kHz clock is more efficient and accurate than the internal RC oscillator
Note: P0.25 (Pin 37) is low drive, low frequency I/O only.

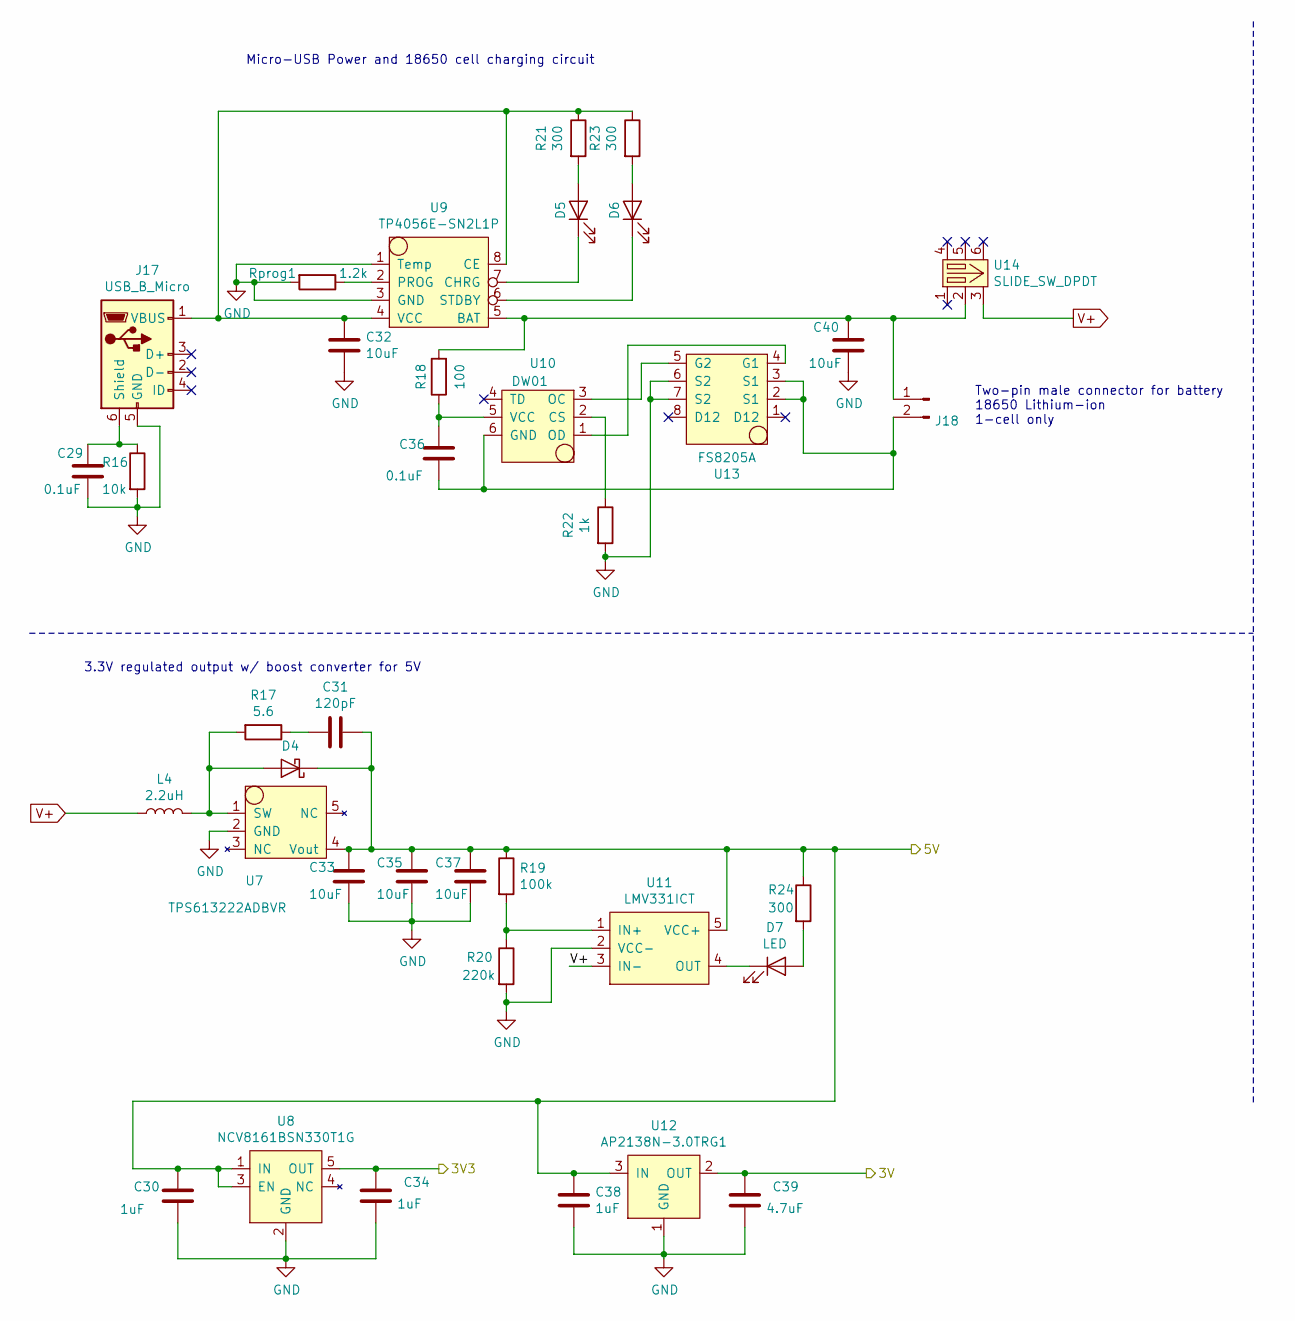
[picture p13: schematic nRF52_Power.sch]

Parts:
C29, C36: 0.1uF; C_0603_1608Metric_Pad1.05x0.95mm_HandSolder
C30, C34, C38: 1uF; C_0603_1608Metric_Pad1.05x0.95mm_HandSolder
C31: 120pF; C_0603_1608Metric_Pad1.05x0.95mm_HandSolder
C32, C33, C35, C37, C40: 10uF; C_0603_1608Metric_Pad1.05x0.95mm_HandSolder
C39: 4.7uF; C_0603_1608Metric_Pad1.05x0.95mm_HandSolder
D4: D_Schottky; D_SOD-123F
D5, D6, D7: LED; LED_0603_1608Metric_Pad1.05x0.95mm_HandSolder
J17: USB_B_Micro; USB_Micro_B_Amphenol_10118194-0001LF
J18: Conn_01x02_Male; PinHeader_1x02_P2.54mm_Horizontal
L4: 2.2uH; L_1008_2520Metric
R16: 10k; R_0603_1608Metric_Pad1.05x0.95mm_HandSolder
R17: 5.6; R_0603_1608Metric_Pad1.05x0.95mm_HandSolder
R18: 100; R_0603_1608Metric_Pad1.05x0.95mm_HandSolder
R19: 100k; R_0603_1608Metric_Pad1.05x0.95mm_HandSolder
R20: 220k; R_0603_1608Metric_Pad1.05x0.95mm_HandSolder
R21, R23, R24: 300; R_0603_1608Metric_Pad1.05x0.95mm_HandSolder
R22: 1k; R_0603_1608Metric_Pad1.05x0.95mm_HandSolder
Rprog1: 1.2k; R_0603_1608Metric_Pad1.05x0.95mm_HandSolder
U7: TPS613222ADBVR; SOT-23-5_HandSoldering
U8: NCV8161BSN330T1G; TSOP-5_1.65x3.05mm_P0.95mm
U9: TP4056E-SN2L1P; SOIC-8-1EP_3.9x4.9mm_P1.27mm_EP2.35x2.35mm
U10: DW01; SOT-23-6_Handsoldering
U11: LMV331ICT; SOT-353_SC-70-5_Handsoldering
U12: AP2138N-3.0TRG1; SOT-23
U13: FS8205A; TSSOP-8_4.4x3mm_P0.65mm
U14: SLIDE_SW_DPDT; SW_DPDT_Slide_JS202011CQN

Connections:
3V3_Ref: C34.1, U8.5 (OUT); also elsewhere on the board
3V_Ref: C39.1, U12.2 (OUT); also elsewhere on the board
5V_Ref: C30.1, C31.1, C33.1, C35.1, C37.1, C38.1, D4.1 (K), R19.1, R24.1, U7.4 (Vout), U8.1 (IN), U8.3 (EN), U11.5 (VCC+), U12.3 (IN); also elsewhere on the board
GND: C29.2, C30.2, C32.2, C33.2, C34.2, C35.2, C37.2, C38.2, C39.2, C40.2, J17.5 (GND), R16.2, R20.2, R22.2, Rprog1.2, U7.2 (GND), U8.2 (GND), U9.1 (Temp), U9.3 (GND), U9.9, U11.2 (VCC-), U12.1 (GND), U13.6 (S2), U13.7 (S2); also elsewhere on the board
unnamed: C29.1, J17.6 (Shield), R16.1
unnamed: C31.2, R17.1
unnamed: C32.1, J17.1 (VBUS), R21.1, R23.1, U9.4 (VCC), U9.8 (CE)
unnamed: C36.1, R18.1, U10.5 (VCC)
unnamed: C36.2, J18.2, U10.6 (GND), U13.2 (S1), U13.3 (S1)
unnamed: C40.1, J18.1, R18.2, U9.5 (BAT), U14.2
unnamed: D4.2 (A), L4.2, R17.2, U7.1 (SW)
unnamed: D5.1 (K), U9.7 (CHRG)
unnamed: D5.2 (A), R21.2
unnamed: D6.1 (K), U9.6 (STDBY)
unnamed: D6.2 (A), R23.2
unnamed: D7.1 (K), U11.4 (OUT)
unnamed: D7.2 (A), R24.2
unnamed: R19.2, R20.1, U11.1 (IN+)
unnamed: R22.1, U10.2 (CS)
unnamed 61: Rprog1.1, U9.2 (PROG); also elsewhere on the board
unnamed: U10.1 (OD), U13.4 (G1)
unnamed: U10.3 (OC), U13.5 (G2)
V+: L4.1, U11.3 (IN-), U14.3; also elsewhere on the board

Notes on the sheet:
Two-pin male connector for battery 18650 Lithium-ion 1-cell only
Micro-USB Power and 18650 cell charging circuit
3.3V regulated output w/ boost converter for 5V

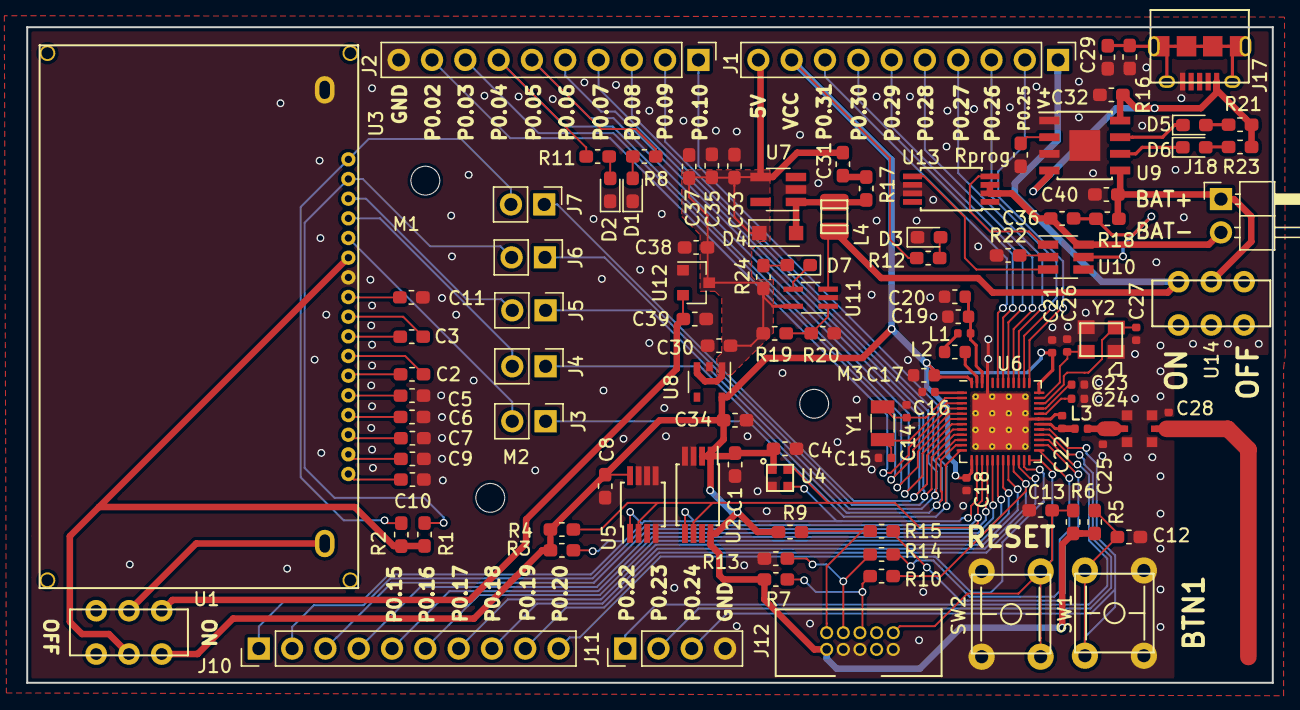
[picture p14: board NRF52832_Reference.kicad_pcb from above]

Board: 2 copper layers, 95.0 x 50.0 mm, 110 parts (0 on the bottom side), 91 nets.

Other parts of the board:
M1, M2, M3: MountingHole_2.2mm_M2
Rprog: 1.2k; R_0603_1608Metric_Pad1.05x0.95mm_HandSolder

Their connections:
GND: Rprog.2; also elsewhere on the board
unnamed 61: Rprog.1; also elsewhere on the board
