jbmister97/projects-hardware/(commit log)

2018-07-26 Testing git...
    [Test1.kicad_pcb, Test1.sch]
2018-08-05 Created project for nrf52832. Created general library to add custom components.
    [NRF52832_Base_Reference.sch, nRF52832_Base.kicad_pcb, nRF52832_Base.sch]
2018-08-06 Added NRF52832 symbol to library and schematic
    [NRF52832_Base_Reference.sch, nRF52832_Base.sch]
2018-08-15 Added nearly finished schematic and layout files for NRF52832.
    [NRF52810_Reference-2018-08-14-21-42-59.sch, NRF52832_Base_Reference.sch, NRF52832_Reference.kicad_pcb, NRF52832_Reference.sch, nRF52832_Base.kicad_pcb, nRF52832_Base.sch]
2018-08-15 Removed unneeded capacitors from P0.25 and P0.26
    [NRF52832_Reference.kicad_pcb, NRF52832_Reference.sch]
2018-08-24 Added finished Arduino Nanite project
    [Tiny_Arduino.PrjPcb, Tiny_Arduino_BOM.xls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]
2018-11-15 Added personal 4-channel motor controller V1 and V2 project files
    [Motor_4_Channel.kicad_pcb, Motor_4_Channel.sch, Motor_4_Channel_V2.kicad_pcb, Motor_4_Channel_V2.sch, Motor_Ouput_4Ch.sch, Motor_Outputs.sch, TI_MSP430_Dev_Boardsch.sch]
2018-11-21 Added power circuit for NRF52. Added SMT Practice V1 project. Modified Motor v2 project.
    [Motor_4_Channel_V2.sch, Motor_Outputs.sch, NRF52832_Reference.sch, SMT_Practice_V1.kicad_pcb, SMT_Practice_V1.sch, nRF52832_base.sch, nRF52_Power.sch]
2018-11-22 Added digikey library. Started PCB layout for Motor 4 CH V2.
    [Motor_4_Channel_V2.kicad_pcb, Motor_4_Channel_V2.sch, Motor_Outputs.sch, familylist_refdes.csv]
2018-11-24 Added progress to Motor 4 CH V2 layout.
    [Motor_4_Channel_V2.kicad_pcb, Motor_4_Channel_V2.sch, Motor_Outputs.sch]
2018-11-25 Initializing pull request for Motor_4CH_V2
    [Motor_4_Channel_V2.kicad_pcb]
2018-11-25 Added project for board that will have a buck converter and a boost converter.
    [DCDC_Buck_and_Boost.kicad_pcb, DCDC_Buck_and_Boost.sch]
2018-12-06 Added I2C components: 4KB EEPROM, Light sensor, and Temp sensor to schematic.
    [NRF52832_Reference.kicad_pcb, NRF52832_Reference.sch, nRF52832_base.sch, nRF52_Power.sch]
2018-12-07 Updated Boost conv. components and moved 3.3V regulator.
    [NRF52832_Reference.sch, nRF52_Power.sch]
2018-12-07 Updated SWD interface headers
    [NRF52832_Reference.sch]
2018-12-07 Added LCD with SPI interface to schematic.
    [NRF52832_Reference.sch, nRF52_Power.sch]
2018-12-07 Updated LCD circuit schematic.
    [NRF52832_Reference.sch, nRF52832_base.sch]
2018-12-08 Added main power switch and LCD power switch. Added GPIO breakout pins.
    [NRF52832_Reference.sch, nRF52832_base.sch, nRF52_Power.sch]
2018-12-08 Added breakout pins for SWDIO and SWDCLK for test purposes.
    [NRF52832_Reference.sch]
2018-12-08 Set footprints for some components of battery charging circuit.
    [nRF52_Power.sch]
2018-12-09 Added Micro USB type B footprint
    [nRF52_Power.sch]
2018-12-09 Added SW_DPDT_Slide footprint. Finished updating footprints for all USB/Battery charger components.
    [nRF52_Power.sch]
2018-12-10 Finished boost converter and regulators footprint assignments.
    [NRF52832_Reference.sch, nRF52_Power.sch]
2018-12-10 Added footprint for LCD and finished footprint assignments for LCD components.
    [NRF52832_Reference.sch, nRF52_Power.sch]
2018-12-10 Finished footprint assignments for I2C components
    [NRF52832_Reference.sch]
2018-12-10 Finished foorprint assignments for GPIO pins, LEDs, and button.
    [NRF52832_Reference.sch, nRF52_Power.sch]
2018-12-11 Finished footprint assignment for SWD Header and Reset button
    [NRF52832_Reference.sch]
2018-12-11 Added series resistors for SWDCLK, SWDIO, and SWO
    [NRF52832_Reference.sch]
2018-12-11 Finished footprint assignments for NRF52 base components
    [NRF52832_Reference.kicad_pcb, NRF52832_Reference.sch, nRF52832_base.sch, nRF52_Power.sch]
2018-12-12 Updated component placement for PCB layout
    [NRF52832_Reference.kicad_pcb, NRF52832_Reference.sch, nRF52_Power.sch]
2018-12-12 Finished component placement on PCB layout. Ready for routing.
    [NRF52832_Reference.kicad_pcb, NRF52832_Reference.sch]
2018-12-12 Finished routing of components. Silkscreen labels still not finished.
    [NRF52832_Reference.kicad_pcb, NRF52832_Reference.sch]
2018-12-13 Finished adding silkscreen labels. Added 3 M2 mounting holes. Generated gerber files.
    [NRF52832_Reference-B.Cu.gbr, NRF52832_Reference-B.Mask.gbr, NRF52832_Reference-B.SilkS.gbr, NRF52832_Reference-Edge.Cuts.gbr, NRF52832_Reference-F.Cu.gbr, NRF52832_Reference-F.Mask.gbr, NRF52832_Reference-F.SilkS.gbr, NRF52832_Reference-NPTH.drl]
2018-12-14 Fixed wrong values for some components
    [nRF52832_base.sch, nRF52_Power.sch]
2018-12-14 Added basic topologies for a buck converter and boost converter to schematic.
2018-12-18 Separated Buck converter and Boost converter projects.
    [Boost_Converter_V1.kicad_pcb, Boost_Converter_V1.sch, Buck_Converter_V1.kicad_pcb, Buck_Converter_V1.sch, DCDC_Buck_and_Boost.sch]
2018-12-18 Added controller circuit
    [Buck_Converter_V1.sch]
2018-12-23 Updated some component values
    [Buck_Converter_V1.sch]
2018-12-23 Changed values for dead time control
    [Buck_Converter_V1.sch]
2018-12-23 Removed unnecessary schottky diode label.
    [Buck_Converter_V1.sch]
2018-12-26 Finished schematic. Changed compensation to Type 3. Added fuse to input. Finished adding values and footprints for all components.
    [Buck_Converter_V1.sch]
2018-12-26 Finished component placement for PCB layout
    [Buck_Converter_V1.sch]
2018-12-26 Finished PCB layout. Ready for Gerber files.
    [Buck_Converter_V1.kicad_pcb]
2018-12-26 Added schematic and PCB layout for USB Type A female connector breakout.
    [USB_TypeA_Breakout_V1.kicad_pcb, USB_TypeA_Breakout_V1.sch]
2018-12-28 Added schematic for a relay to control an outlet.
    [Outlet_Relay_V1.kicad_pcb, Outlet_Relay_V1.sch]
2018-12-31 Added footprints to resistors.
    [Outlet_Relay_V1.sch]
2018-12-31 Set footprints for flyback diode and mosfet
    [Outlet_Relay_V1.sch]
2019-01-01 Finished PCB layout. Generated BOM.
    [Outlet_Relay_V1.sch]
2019-01-01 Changed out+ and out- pads to be 7.62mm apart to make it easy to attach USB breakout board.
    [Buck_Converter_V1.kicad_pcb]
2019-01-01 Added rounded corners to PCB layout.
    [USB_TypeA_Breakout_V1.kicad_pcb]
2019-01-01 Generated gerber files
    [USB_TypeA_Breakout_V1-B.Cu.gbr, USB_TypeA_Breakout_V1-B.Mask.gbr, USB_TypeA_Breakout_V1-B.SilkS.gbr, USB_TypeA_Breakout_V1-Edge.Cuts.gbr, USB_TypeA_Breakout_V1-F.Cu.gbr, USB_TypeA_Breakout_V1-F.Mask.gbr, USB_TypeA_Breakout_V1-F.SilkS.gbr, USB_TypeA_Breakout_V1-NPTH.drl]
2019-01-01 Changed footprint for PMOS switch. Generated gerber files.
    [Buck_Converter_V1-B.Cu.gbr, Buck_Converter_V1-B.Mask.gbr, Buck_Converter_V1-B.SilkS.gbr, Buck_Converter_V1-Edge.Cuts.gbr, Buck_Converter_V1-F.Cu.gbr, Buck_Converter_V1-F.Mask.gbr, Buck_Converter_V1-F.SilkS.gbr, Buck_Converter_V1-NPTH.drl]
2019-01-02 Created BOM file.
2019-01-04 Generated gerber files.
    [Outlet_Relay_V1-B.Cu.gbr, Outlet_Relay_V1-B.Mask.gbr, Outlet_Relay_V1-B.SilkS.gbr, Outlet_Relay_V1-Edge.Cuts.gbr, Outlet_Relay_V1-F.Cu.gbr, Outlet_Relay_V1-F.Mask.gbr, Outlet_Relay_V1-F.SilkS.gbr, Outlet_Relay_V1-NPTH.drl]
2019-01-04 Renamed gerber zip file.
2019-01-05 Updating branch
    [Buck_Converter_V1.sch]
2019-01-06 Updating rescue lib for NRF52 Reference.
    [NRF52832_Reference.sch, nRF52832_base.sch, nRF52_Power.sch]
2019-01-06 Fixed project library
    [USB_TypeA_Breakout_V1.sch]
